JulesEtLeo/Tank-arduino/PRESENTATION PROJET (pdf).pdf

# PROJET ARDUINO PeiP 2

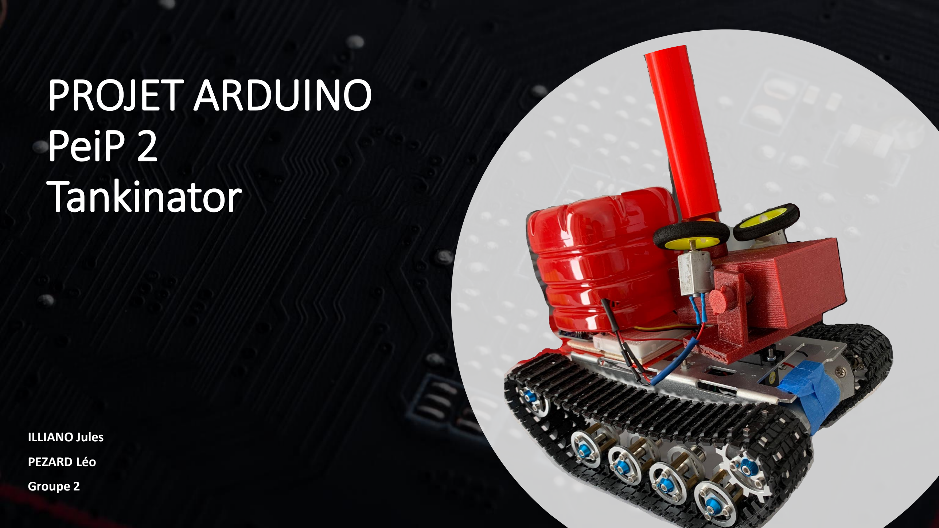
[picture p15: page 1]

# Tankinator

ILLIANO Jules

PEZARD Léo

Groupe 2

# SOMMAIRE

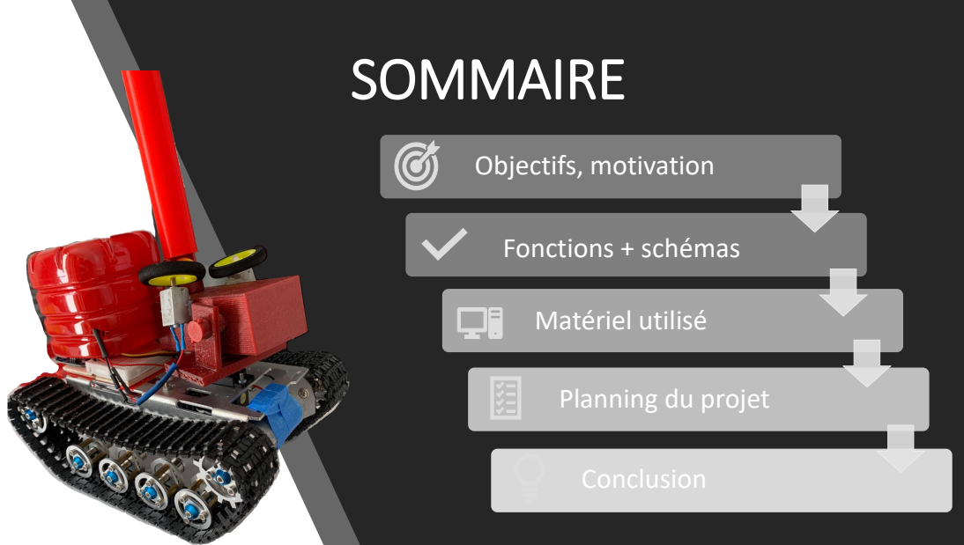
[picture p16: page 2]
Objectifs, motivation; Fonctions + schémas; Matériel utilisé; Conclusion

Planning du projet

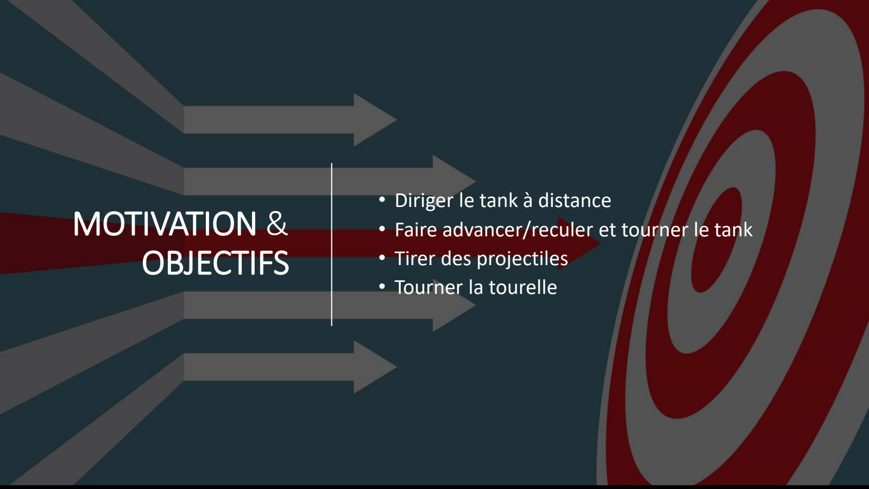
[picture p17: page 3]

## MOTIVATION & OBJECTIFS

- Diriger le tank à distance
- Faire advancer/reculer et tourner le tank
- Tirer des projectiles
- Tourner la tourelle

# CODE +SCHEMA

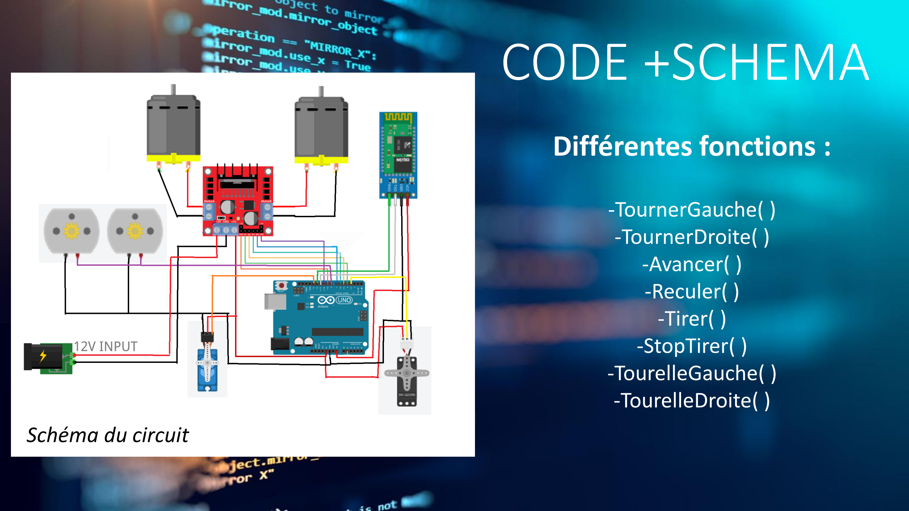
[picture p18: page 4]

## Différentes fonctions :

-TournerGauche( )
-TournerDroite( )
-Avancer( )
-Reculer( )
-Tirer( )
-StopTirer( )
-TourelleGauche( )
-TourelleDroite( )
Schéma du circuit

# MATÉRIEL UTILISÉ

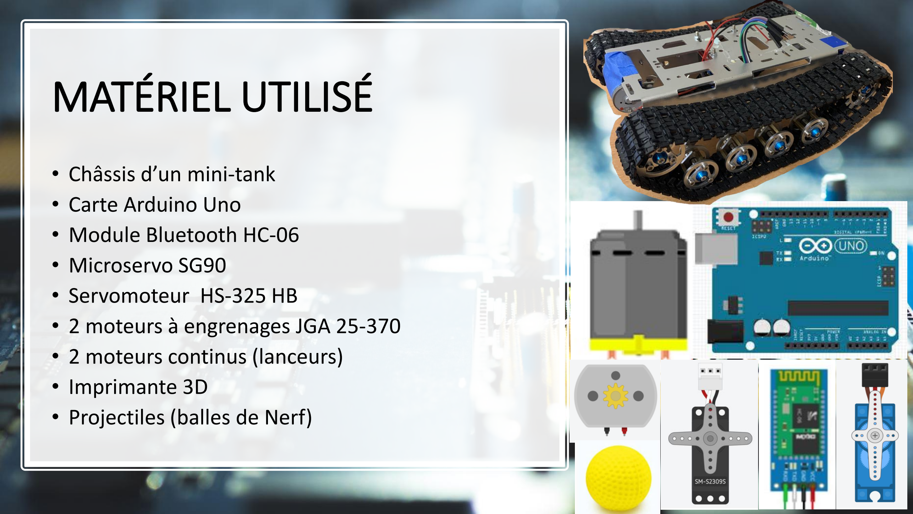
[picture p19: page 5]

- Châssis d’un mini-tank
- Carte Arduino Uno
- Module Bluetooth HC-06
- Microservo SG90
- Servomoteur HS-325 HB
- 2 moteurs à engrenages JGA 25-370
- 2 moteurs continus (lanceurs)
- Imprimante 3D
- Projectiles (balles de Nerf)

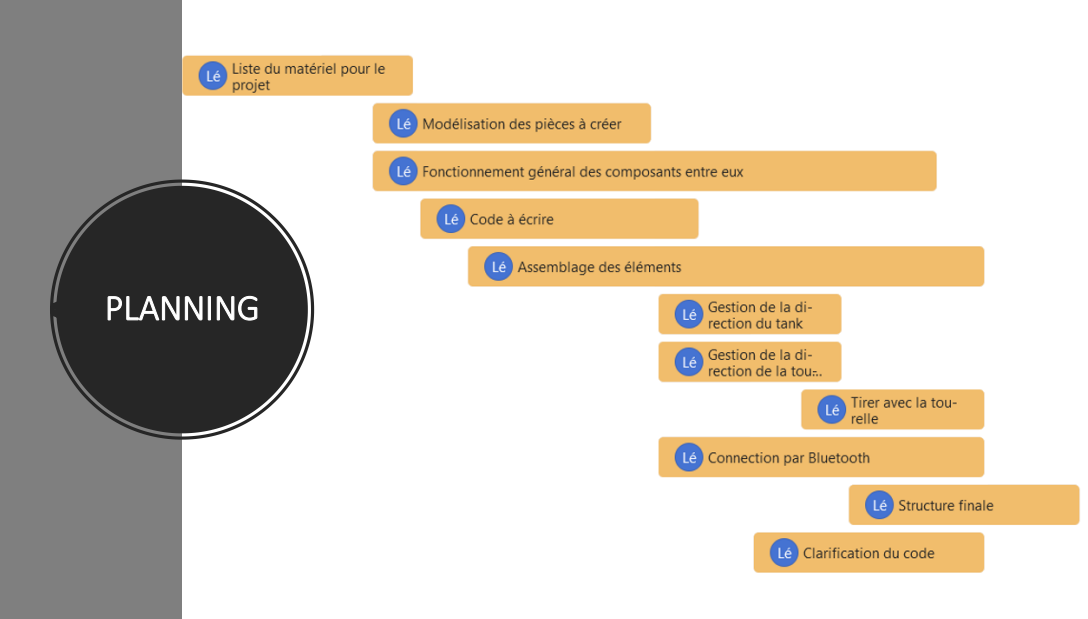
[picture p20: page 6]
PLANNING

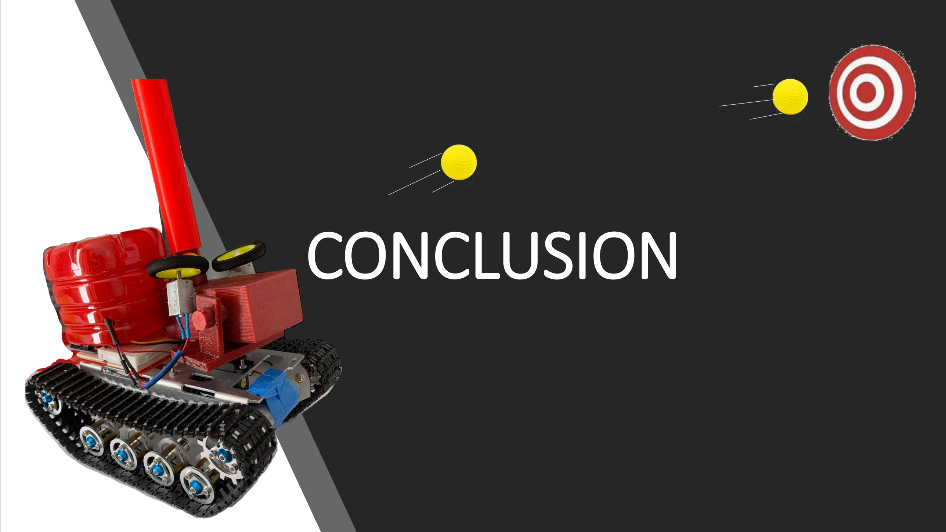
[picture p21: page 7]

# CONCLUSION
