JulesEtLeo/Tank-arduino/Liste des séances.odt

Séance n° | Etapes
1 | - Liste des fonctionnalités du tank (donc liste du matériel « technique » a commander + étudier chaque composant Arduino nécessaire (forme, branchements...) -La forme des composant va légèrement impacter le design du tank que nous allons adapter. -Liste du matériel « design » (principalement les chenilles, le châssis du tank et la coque) - Choisir comment notre tank va avancer, se tourner/ tourner la tourelle …(Bluetooth) - Récupérer les codes déjà faits en TD (avancer la voiture, commander par Bluetooth, détecteur de distance...) et prévoir les modifications à nos contraintes.
2 | -Début du code avec les pièces que nous avons déjà (détecteur de distance, servomoteurs...) -Recherche de codes pour les nouveaux composants jamais étudiés (tourelle, lanceur...) - Coder pour chaque élément 7-8
3-4-5-6 | - Continuité du codage de chaque besoin, - Mise en commun des codes, test s'il y a des bugs, vérifier que les éléments interagissent bien entre eux. - Vérifier que les commandes par Bluetooth/ manette marchent -Construction de la coque, de la tourelle
7_8 | - Assemblage de chaque élément sur un squelette pour tester le fonctionnement - Premier montage avec la coque, le châssis, la tourelle du tank. - Régler les problèmes dus a la forme de la coque/ du châssis ... - Montage final du tank
9 | Oral de soutenance du projet
